pekeppp/chippaint-v3.2/rtl/tb/tb_dl_arb.v

/* =========================================================================
 * tb_dl_arb.v — **三流共存**读仲裁测试台（S2 最大未验证风险：engine fg/bg 与
 *              显示列表 desc 抢 axi_rd_master，且扫描输出还在更上层抢 DDR）
 * -------------------------------------------------------------------------
 * 为什么要这个台：S2 给 axi_rd_master 加了第三个读流（描述符/几何表，rd_sel=10）
 * 和"引擎 > desc / AGE_MAX=64 提权"的仲裁，但**没有任何测试台同时跑过三条流**。
 * 本台按 SoC 的真实两层结构搭（见 ARC_2DRA/rtl/ddr3_example_top.v）：
 *
 *   fg 请求器 ─┐
 *   bg 请求器 ─┼─► axi_rd_master（DUT，三流仲裁：引擎 > desc，AGE_MAX=64）
 *   desc 请求器┘        │ AXI 主口
 *                       ▼
 *   CPU 模型 ──► axi_rd_arb L1（s = BitBlt 读主机，优先级更高，WAIT_MAX=32）
 *                       │
 *                       ▼
 *   扫描输出行取数模型 ─► axi_rd_arb L2（s = 扫描输出，最高优先，LEAK_TO=256）
 *                       │
 *                       ▼
 *                 axi_slave_mem（AR_LAT=20，MAXO=4 ⇒ 真实读延迟）
 *
 * 断言（逐条对应任务书）：
 *   1) **不饿死**：每条流的最长"等受理"拍数有界（逐个打印实测值）；
 *   2) **不挂死**：全局看门狗 + 每条流的完成笔数下限；
 *   3) **不丢/不重**：每条流每一拍的数据与该地址的存储器图案逐一比对，
 *      并且弹出的笔数 == 发出的笔数（每笔拍数也核）；
 *   4) **仲裁器既有保证**（§17/§18.8）：
 *      · 有界公平：扫描输出连续占用时，CPU 侧等够 WAIT_MAX 一定能过一笔；
 *      · 泄漏兜底：扫描输出"放弃本行"（rlast 永不来）后，owner 必须在
 *        LEAK_TO 拍内归还，CPU 侧随后能继续完成突发（= 整机不会被永久锁死）。
 *
 * 编译运行（仓库根）：
 *   $env:PATH = "C:\oss-cad-suite\bin;C:\oss-cad-suite\lib;$env:PATH"
 *   iverilog -g2001 -s tb_dl_arb -o sim_tb_dl_arb.vvp rtl/axi_rd_master.v \
 *     ARC_2DRA/rtl/video/axi_rd_arb.v rtl/tb/axi_slave_mem.v rtl/tb/tb_dl_arb.v
 *   vvp sim_tb_dl_arb.vvp
 * ========================================================================= */
`timescale 1ns/1ps
module tb_dl_arb;
    /* ★2026-09-25 参数级调优：desc 提权阈值暴露成**顶层参数**（原来硬编码 64）。
     *   扫描：ModelSim `-gAGE_MAX_P=16|32|64|96`。
     *   判据看 P1 行的四方等待：desc 最长等待应 ≈ AGE_MAX（提权生效），
     *   同时 fg/bg 的等待不能涨到影响像素通路（它们是引擎的关键路径）。 */
    parameter AGE_MAX_P = 64;
    /* ★2026-09-25：在飞突发数也暴露出来——它才是 desc 能不能拿到读口的**第一道门**
     *   （`credit = (arq_cnt+rq_cnt) < OUTSTAND`）。扫描 `-gOUTSTAND_P=4|6|8`。 */
    parameter OUTSTAND_P = 4;

    localparam AW = 28, DW = 128;

    reg clk = 1'b0, rst_n = 1'b0;
    always #5 clk = ~clk;

    integer cyc = 0;
    always @(posedge clk) cyc = cyc + 1;

    /* 地址分区（存储器只有 32KB：0x0000..0x7FFF；每区 ≤ 4KB） */
    localparam [AW-1:0] FG_BASE   = 28'h0000;
    localparam [AW-1:0] BG_BASE   = 28'h2000;
    localparam [AW-1:0] DESC_BASE = 28'h4000;
    localparam [AW-1:0] CPU_BASE  = 28'h5000;
    localparam [AW-1:0] SCAN_BASE = 28'h6000;

    integer errors = 0;
    integer i;

    /* ================= 引擎三流 ↔ DUT（axi_rd_master） ================= */
    reg         fg_iss;      reg [31:0] fg_addr;   reg [7:0] fg_len;
    reg         bg_iss;      reg [31:0] bg_addr;   reg [7:0] bg_len;
    reg         dl_iss;      reg [31:0] dl_addr;   reg [7:0] dl_len;
    wire        rd_ready, dl_ready, rd_busy, rd_done;
    wire [1:0]  rd_tag_out;

    wire        fg_win = fg_iss;                       // 引擎侧 fg 优先（与 FSM 一致）
    wire        bg_win = !fg_iss && bg_iss;
    wire        rd_req  = (fg_win || bg_win) && rd_ready;   // 与引擎同风格：ready 门控
    wire [31:0] rd_addr = fg_win ? fg_addr : bg_addr;
    wire [7:0]  rd_len  = fg_win ? fg_len  : bg_len;
    wire [1:0]  rd_sel  = fg_win ? 2'b00   : 2'b01;
    wire        fg_acc  = fg_win && rd_ready;
    wire        bg_acc  = bg_win && rd_ready;
    wire        dl_acc  = dl_iss && dl_ready;

    wire [DW-1:0] rd_data;
    wire [1:0]    rd_rresp;
    wire          fg_rvalid, bg_rvalid, desc_rvalid;

    wire [31:0]   blt_araddr;              // DUT 的主口是 32bit 地址，仲裁器 AW=28
    wire [7:0]    blt_arlen;
    wire [2:0]    blt_arsize;
    wire [1:0]    blt_arburst;
    wire          blt_arvalid, blt_arready;
    wire [DW-1:0] blt_rdata;
    wire [1:0]    blt_rresp;
    wire          blt_rlast, blt_rvalid, blt_rready;

    axi_rd_master #(.AXI_DATA_W(DW), .MAX_BEATS(16), .OUTSTAND(OUTSTAND_P), .AGE_MAX(AGE_MAX_P)) u_dut (
        .clk(clk), .rst_n(rst_n),
        .rd_req(rd_req), .rd_addr(rd_addr), .rd_len(rd_len), .rd_sel(rd_sel),
        .rd_ready(rd_ready), .rd_busy(rd_busy), .rd_done(rd_done), .rd_tag_out(rd_tag_out),
        .dl_req(dl_iss), .dl_addr(dl_addr), .dl_len(dl_len), .dl_ready(dl_ready),
        .fg_rready(1'b1), .bg_rready(1'b1), .desc_rready(1'b1),
        .fg_rvalid(fg_rvalid), .bg_rvalid(bg_rvalid), .desc_rvalid(desc_rvalid),
        .rdata(rd_data), .rd_rresp(rd_rresp),
        .m_axi_araddr(blt_araddr), .m_axi_arlen(blt_arlen), .m_axi_arsize(blt_arsize),
        .m_axi_arburst(blt_arburst), .m_axi_arvalid(blt_arvalid), .m_axi_arready(blt_arready),
        .m_axi_rdata(blt_rdata), .m_axi_rresp(blt_rresp), .m_axi_rlast(blt_rlast),
        .m_axi_rvalid(blt_rvalid), .m_axi_rready(blt_rready)
    );

    /* ================= L1 仲裁：CPU 模型 (c) ↔ BitBlt 读主机 (s) ================= */
    reg  [AW-1:0] cpu_araddr;  reg [7:0] cpu_arlen;  reg cpu_arvalid;  wire cpu_arready;
    wire [DW-1:0] cpu_rdata;   wire [1:0] cpu_rresp; wire [3:0] cpu_rid;
    wire          cpu_rlast, cpu_rvalid;  reg  cpu_rready;
    wire [AW-1:0] m1_araddr;   wire [7:0] m1_arlen;  wire [2:0] m1_arsize;
    wire [1:0]    m1_arburst;  wire [3:0] m1_arid;   wire m1_arvalid, m1_arready;
    wire [DW-1:0] m1_rdata;    wire [1:0] m1_rresp;  wire [3:0] m1_rid;
    wire          m1_rlast, m1_rvalid, m1_rready;

    axi_rd_arb #(.AW(AW), .DW(DW), .IDW(4), .S_PRIO(0), .WAIT_MAX(8'd32), .LEAK_TO(16'd256))
    u_l1 (
        .clk(clk), .rst_n(rst_n),
        .c_araddr(cpu_araddr), .c_arlen(cpu_arlen), .c_arsize(3'd4), .c_arburst(2'b01),
        .c_arid(4'h0), .c_arvalid(cpu_arvalid), .c_arready(cpu_arready),
        .c_rdata(cpu_rdata), .c_rresp(cpu_rresp), .c_rid(cpu_rid), .c_rlast(cpu_rlast),
        .c_rvalid(cpu_rvalid), .c_rready(cpu_rready),
        .s_araddr(blt_araddr[AW-1:0]), .s_arlen(blt_arlen), .s_arsize(blt_arsize),
        .s_arburst(blt_arburst), .s_arvalid(blt_arvalid), .s_arready(blt_arready),
        .s_hold(1'b0),                                   // 引擎不提供整行钉住（同顶层）
        .s_rdata(blt_rdata), .s_rresp(blt_rresp), .s_rlast(blt_rlast),
        .s_rvalid(blt_rvalid), .s_rready(blt_rready),
        .m_araddr(m1_araddr), .m_arlen(m1_arlen), .m_arsize(m1_arsize),
        .m_arburst(m1_arburst), .m_arid(m1_arid), .m_arvalid(m1_arvalid),
        .m_arready(m1_arready),
        .m_rdata(m1_rdata), .m_rresp(m1_rresp), .m_rid(m1_rid), .m_rlast(m1_rlast),
        .m_rvalid(m1_rvalid), .m_rready(m1_rready)
    );

    /* ================= L2 仲裁：L1 汇总 (c) ↔ 扫描输出行取数模型 (s) ================= */
    reg  [AW-1:0] sc_araddr;  reg [7:0] sc_arlen;  reg sc_arvalid;  reg sc_hold;
    wire          sc_arready;
    wire [DW-1:0] sc_rdata;   wire [1:0] sc_rresp; wire sc_rlast, sc_rvalid;
    reg           sc_rready;
    wire [AW-1:0] m2_araddr;  wire [7:0] m2_arlen;  wire [2:0] m2_arsize;
    wire [1:0]    m2_arburst; wire [3:0] m2_arid;   wire m2_arvalid, m2_arready;
    wire [DW-1:0] m2_rdata;   wire [1:0] m2_rresp;  wire [3:0] m2_rid;
    wire          m2_rlast, m2_rvalid, m2_rready;

    axi_rd_arb #(.AW(AW), .DW(DW), .IDW(4), .S_PRIO(0), .WAIT_MAX(8'd32), .LEAK_TO(16'd256))
    u_l2 (
        .clk(clk), .rst_n(rst_n),
        .c_araddr(m1_araddr), .c_arlen(m1_arlen), .c_arsize(m1_arsize),
        .c_arburst(m1_arburst), .c_arid(m1_arid), .c_arvalid(m1_arvalid),
        .c_arready(m1_arready),
        .c_rdata(m1_rdata), .c_rresp(m1_rresp), .c_rid(m1_rid), .c_rlast(m1_rlast),
        .c_rvalid(m1_rvalid), .c_rready(m1_rready),
        .s_araddr(sc_araddr), .s_arlen(sc_arlen), .s_arsize(3'd4), .s_arburst(2'b01),
        .s_arvalid(sc_arvalid), .s_arready(sc_arready), .s_hold(sc_hold),
        .s_rdata(sc_rdata), .s_rresp(sc_rresp), .s_rlast(sc_rlast),
        .s_rvalid(sc_rvalid), .s_rready(sc_rready),
        .m_araddr(m2_araddr), .m_arlen(m2_arlen), .m_arsize(m2_arsize),
        .m_arburst(m2_arburst), .m_arid(m2_arid), .m_arvalid(m2_arvalid),
        .m_arready(m2_arready),
        .m_rdata(m2_rdata), .m_rresp(m2_rresp), .m_rid(m2_rid), .m_rlast(m2_rlast),
        .m_rvalid(m2_rvalid), .m_rready(m2_rready)
    );

    axi_slave_mem #(.AXI_DATA_W(DW), .MEM_BYTES(1 << 15), .AR_LAT(20), .B_LAT(2), .MAXO(4)) u_mem (
        .clk(clk), .rst_n(rst_n),
        .s_araddr({4'd0, m2_araddr}), .s_arlen(m2_arlen), .s_arsize(m2_arsize),
        .s_arburst(m2_arburst), .s_arvalid(m2_arvalid), .s_arready(m2_arready),
        .s_rdata(m2_rdata), .s_rresp(m2_rresp), .s_rlast(m2_rlast),
        .s_rvalid(m2_rvalid), .s_rready(m2_rready),
        .s_awaddr(32'd0), .s_awlen(8'd0), .s_awsize(3'd4), .s_awburst(2'b01),
        .s_awvalid(1'b0), .s_awready(), .s_wdata(128'd0), .s_wstrb(16'd0),
        .s_wlast(1'b0), .s_wvalid(1'b0), .s_wready(), .s_bvalid(), .s_bresp(),
        .s_bready(1'b0)
    );

    /* ================= 期望数据（与存储器图案同源：mem[k] = k[7:0] ^ k[15:8]） ================= */
    function [127:0] exp_beat;
        input [31:0] a;                      // 16B 对齐的拍地址
        integer      k;
        reg   [31:0] ai;
        begin
            exp_beat = 128'd0;
            for (k = 0; k < 16; k = k + 1) begin
                ai = a + k;
                exp_beat[k*8 +: 8] = ai[7:0] ^ ai[15:8];
            end
        end
    endfunction

    /* ================= 每流的在飞突发队列 + 统计 ================= */
    reg [31:0] fgq_a [0:15];  reg [7:0] fgq_n [0:15];  integer fgq_w, fgq_r;
    reg [31:0] bgq_a [0:15];  reg [7:0] bgq_n [0:15];  integer bgq_w, bgq_r;
    reg [31:0] dlq_a [0:15];  reg [7:0] dlq_n [0:15];  integer dlq_w, dlq_r;
    reg [7:0]  fg_bc, bg_bc, dl_bc;
    integer fg_bursts, bg_bursts, dl_bursts;
    integer fg_beats,  bg_beats,  dl_beats;
    integer fg_err,    bg_err,    dl_err;
    integer fg_stray,  bg_stray,  dl_stray;      // 泄漏兜底后被错路的拍（如实记账）
    integer fg_wait_max, bg_wait_max, dl_wait_max, cpu_wait_max, scan_wait_max;
    integer fg_wait, bg_wait, dl_wait, cpu_wait, scan_wait;
    integer leak_mode;                           // 1 = 已进入泄漏测试阶段
    integer req_en;                              // 0 = 三条引擎流停止发请求（排空用）

    task chk;
        input ok;
        input [255:0] name;
        begin
            if (!ok) begin errors = errors + 1; $display("FAIL: %0s", name); end
            else $display("PASS: %0s", name);
        end
    endtask

    /* ================= 请求器：fg / bg（引擎源读，8 拍突发） =================
     * 占空比按真实引擎来：它受 OUTSTAND=4 与行缓冲 FIFO 的反压，**不是每拍都发**。
     * 本台给"连发 N 笔 → 停 M 拍"的节奏（引擎侧 s_arvalid 会周期性落下），
     * 这样 L1 的"BitBlt > CPU"才有让位窗口 —— 若让 fg 永不放手，L1 的 CPU 侧
     * 会被**整个命令期间**挡住（该行为是 §18 设计取舍，不是本 TB 要测的东西）。 */
    integer fg_next, bg_next, fg_run, bg_run;
    reg [3:0] fg_gap, bg_gap;
    reg [7:0] fg_pause, bg_pause;

    initial begin
        fg_iss = 0; fg_addr = FG_BASE; fg_len = 8'd8; fg_next = 0; fg_gap = 0;
        bg_iss = 0; bg_addr = BG_BASE; bg_len = 8'd8; bg_next = 0; bg_gap = 0;
        fgq_w = 0; fgq_r = 0; bgq_w = 0; bgq_r = 0; fg_bc = 0; bg_bc = 0;
        fg_bursts = 0; bg_bursts = 0; fg_beats = 0; bg_beats = 0; fg_err = 0; bg_err = 0;
        fg_stray = 0; bg_stray = 0; dl_stray = 0; leak_mode = 0; req_en = 1;
        fg_wait = 0; bg_wait = 0; fg_wait_max = 0; bg_wait_max = 0;
        fg_run = 0; bg_run = 0; fg_pause = 0; bg_pause = 0;
    end

    always @(posedge clk or negedge rst_n) begin
        if (!rst_n) begin
            fg_iss <= 1'b0; bg_iss <= 1'b0; fg_wait <= 0; bg_wait <= 0;
        end else begin
            /* ---- fg ---- */
            if (fg_pause != 0) begin
                fg_pause <= fg_pause - 8'd1;  fg_iss <= 1'b0;
            end else if (!req_en) begin
                fg_iss <= 1'b0;
            end else if (!fg_iss) begin
                if (fg_gap != 0) fg_gap <= fg_gap - 4'd1;
                else begin
                    fg_iss  <= 1'b1;
                    fg_addr <= FG_BASE + (fg_next % 16) * 128;      // 8 拍 = 128B/笔
                    fg_len  <= 8'd8;
                end
            end else begin
                if (fg_acc) begin
                    fg_iss <= 1'b0;
                    fg_gap <= 4'd1;
                    fgq_a[fgq_w[3:0]] <= fg_addr;
                    fgq_n[fgq_w[3:0]] <= fg_len;
                    fgq_w <= fgq_w + 1;
                    fg_bursts <= fg_bursts + 1;
                    fg_next <= fg_next + 1;
                    if (fg_wait > fg_wait_max) fg_wait_max <= fg_wait;
                    fg_wait <= 0;
                    fg_run  <= fg_run + 1;
                    if (fg_run >= 7) begin           // 连发 8 笔 → 停 24 拍（行反压）
                        fg_pause <= 8'd24;
                        fg_run   <= 0;
                    end
                end else begin
                    if (fg_wait != 1000000) fg_wait <= fg_wait + 1;
                end
            end
            /* ---- bg ---- */
            if (bg_pause != 0) begin
                bg_pause <= bg_pause - 8'd1;  bg_iss <= 1'b0;
            end else if (!req_en) begin
                bg_iss <= 1'b0;
            end else if (!bg_iss) begin
                if (bg_gap != 0) bg_gap <= bg_gap - 4'd1;
                else begin
                    bg_iss  <= 1'b1;
                    bg_addr <= BG_BASE + (bg_next % 16) * 128;
                    bg_len  <= 8'd8;
                end
            end else begin
                if (bg_acc) begin
                    bg_iss <= 1'b0;
                    bg_gap <= 4'd1;
                    bgq_a[bgq_w[3:0]] <= bg_addr;
                    bgq_n[bgq_w[3:0]] <= bg_len;
                    bgq_w <= bgq_w + 1;
                    bg_bursts <= bg_bursts + 1;
                    bg_next <= bg_next + 1;
                    if (bg_wait > bg_wait_max) bg_wait_max <= bg_wait;
                    bg_wait <= 0;
                    bg_run  <= bg_run + 1;
                    if (bg_run >= 5) begin           // 连发 6 笔 → 停 40 拍（与 fg 错开）
                        bg_pause <= 8'd40;
                        bg_run   <= 0;
                    end
                end else begin
                    if (bg_wait != 1000000) bg_wait <= bg_wait + 1;
                end
            end
        end
    end

    /* ---- fg/bg 回程检查：数据逐拍比对 + 笔数/拍数核对 ----
     * 泄漏（P2）之后总线归属会短暂错乱，落在这两条流上的"别人的拍"按 stray 记账，
     * 不再算数据错 —— 这正是 §18.8 兜底的已知代价，必须如实记录而不是藏着。 */
    always @(posedge clk) if (rst_n) begin
        if (fg_rvalid) begin
            if (rd_data !== exp_beat(fgq_a[fgq_r[3:0]] + {24'd0, fg_bc} * 16)) begin
                if (leak_mode) fg_stray = fg_stray + 1;
                else begin
                    if (fg_err < 3)
                        $display("      FG DATA MISMATCH addr=%h beat=%0d got=%h",
                                 fgq_a[fgq_r[3:0]] + {24'd0, fg_bc}*16, fg_bc, rd_data);
                    fg_err = fg_err + 1;
                end
            end
            fg_beats = fg_beats + 1;
            if (fg_bc == fgq_n[fgq_r[3:0]] - 8'd1) begin fg_bc = 0; fgq_r = fgq_r + 1; end
            else fg_bc = fg_bc + 8'd1;
        end
        if (bg_rvalid) begin
            if (rd_data !== exp_beat(bgq_a[bgq_r[3:0]] + {24'd0, bg_bc} * 16)) begin
                if (leak_mode) bg_stray = bg_stray + 1;
                else begin
                    if (bg_err < 3)
                        $display("      BG DATA MISMATCH addr=%h beat=%0d got=%h",
                                 bgq_a[bgq_r[3:0]] + {24'd0, bg_bc}*16, bg_bc, rd_data);
                    bg_err = bg_err + 1;
                end
            end
            bg_beats = bg_beats + 1;
            if (bg_bc == bgq_n[bgq_r[3:0]] - 8'd1) begin bg_bc = 0; bgq_r = bgq_r + 1; end
            else bg_bc = bg_bc + 8'd1;
        end
    end

    /* ================= 请求器：desc（描述符取指，8 拍块 + 1 拍几何表交替） ================= */
    integer dl_next;
    reg [7:0] dl_gap_c;
    initial begin
        dl_iss = 0; dl_addr = DESC_BASE; dl_len = 8'd1; dl_next = 0; dl_gap_c = 8'd0;
        dlq_w = 0; dlq_r = 0; dl_bc = 0;
        dl_bursts = 0; dl_beats = 0; dl_err = 0; dl_wait = 0; dl_wait_max = 0;
    end

    always @(posedge clk or negedge rst_n) begin
        if (!rst_n) begin
            dl_iss <= 1'b0; dl_wait <= 0;
        end else begin
            if (!req_en) begin
                dl_iss <= 1'b0;
            end else if (!dl_iss) begin
                if (dl_gap_c != 0) dl_gap_c <= dl_gap_c - 8'd1;
                else begin
                    dl_iss  <= 1'b1;
                    dl_addr <= DESC_BASE + (dl_next % 24) * 128;
                    dl_len  <= ((dl_next % 4) == 3) ? 8'd1 : 8'd8;
                end
            end else begin
                if (dl_acc) begin
                    dl_iss   <= 1'b0;
                    dl_gap_c <= 8'd24 + (dl_next % 5) * 8;    // 周期 ~25 拍
                    dlq_a[dlq_w[3:0]] <= dl_addr;
                    dlq_n[dlq_w[3:0]] <= dl_len;
                    dlq_w    <= dlq_w + 1;
                    dl_bursts<= dl_bursts + 1;
                    dl_next  <= dl_next + 1;
                    if (dl_wait > dl_wait_max) dl_wait_max <= dl_wait;
                    dl_wait  <= 0;
                end else begin
                    if (dl_wait != 1000000) dl_wait <= dl_wait + 1;
                end
            end
        end
    end

    always @(posedge clk) if (rst_n) begin
        if (desc_rvalid) begin
            if (rd_data !== exp_beat(dlq_a[dlq_r[3:0]] + {24'd0, dl_bc} * 16)) begin
                if (leak_mode) dl_stray = dl_stray + 1;
                else begin
                    if (dl_err < 3)
                        $display("      DESC DATA MISMATCH addr=%h beat=%0d got=%h",
                                 dlq_a[dlq_r[3:0]] + {24'd0, dl_bc}*16, dl_bc, rd_data);
                    dl_err = dl_err + 1;
                end
            end
            dl_beats = dl_beats + 1;
            if (dl_bc == dlq_n[dlq_r[3:0]] - 8'd1) begin dl_bc = 0; dlq_r = dlq_r + 1; end
            else dl_bc = dl_bc + 8'd1;
        end
    end

    /* ================= CPU 模型（L1 的 c 侧）：连续 4 拍读，量"有界公平" ================= */
    integer cpu_next, cpu_done, cpu_stray;
    reg [1:0]    cpu_st;
    reg [AW-1:0] cpu_araddr_cur;
    reg [7:0]    cpu_bc;
    reg          cpu_ok;
    initial begin
        cpu_araddr = CPU_BASE; cpu_arlen = 8'd4; cpu_arvalid = 1'b0; cpu_rready = 1'b1;
        cpu_next = 0; cpu_done = 0; cpu_stray = 0; cpu_wait = 0; cpu_wait_max = 0;
        cpu_st = 2'd0; cpu_araddr_cur = CPU_BASE; cpu_bc = 0;
    end

    always @* cpu_ok = (cpu_rdata === exp_beat(cpu_araddr_cur + {24'd0, cpu_bc}*16));

    always @(posedge clk or negedge rst_n) begin
        if (!rst_n) begin
            cpu_st <= 2'd0; cpu_arvalid <= 1'b0; cpu_wait <= 0;
        end else case (cpu_st)
            2'd0: begin
                cpu_araddr <= CPU_BASE + (cpu_next % 16) * 64;   // 4 拍 = 64B/笔
                cpu_arvalid<= 1'b1;
                if (cpu_arvalid && cpu_arready) begin
                    cpu_arvalid <= 1'b0;
                    cpu_st      <= 2'd1;
                    cpu_araddr_cur <= cpu_araddr;
                    cpu_bc      <= 8'd0;
                    cpu_wait    <= 0;
                end else begin
                    if (cpu_wait != 1000000) cpu_wait <= cpu_wait + 1;
                    if (cpu_wait > cpu_wait_max) cpu_wait_max <= cpu_wait;
                end
            end
            default: begin
                if (cpu_rvalid) begin
                    /* 数据对得上就前进；对不上按 stray 记账（泄漏兜底后的错路拍） */
                    if (cpu_ok) begin
                        if (cpu_rlast) begin
                            cpu_done <= cpu_done + 1;
                            cpu_next <= cpu_next + 1;
                            cpu_st   <= 2'd0;
                        end else
                            cpu_bc <= cpu_bc + 8'd1;
                    end else
                        cpu_stray <= cpu_stray + 1;
                end else begin
                    if (cpu_wait != 1000000) cpu_wait <= cpu_wait + 1;
                    if (cpu_wait > cpu_wait_max) cpu_wait_max <= cpu_wait;
                end
            end
        endcase
    end

    /* ================= 扫描输出模型（L2 的 s 侧）：周期性整行取数 ================= */
    integer scan_line, scan_bursts, scan_beats, scan_err, scan_gap_c;
    reg [1:0] scan_st;                  // 0=等行周期, 1=发 AR, 2=收数据
    reg       scan_abandon;             // 1 = 本次故意"放弃本行"（泄漏测试）
    initial begin
        sc_araddr = SCAN_BASE; sc_arlen = 8'd15; sc_arvalid = 1'b0; sc_hold = 1'b0;
        sc_rready = 1'b1; scan_st = 2'd0; scan_line = 0;
        scan_bursts = 0; scan_beats = 0; scan_err = 0; scan_gap_c = 0;
        scan_wait = 0; scan_wait_max = 0; scan_abandon = 1'b0;
    end

    always @(posedge clk or negedge rst_n) begin
        if (!rst_n) begin
            scan_st <= 2'd0; sc_arvalid <= 1'b0; sc_hold <= 1'b0; scan_wait <= 0;
        end else case (scan_st)
            2'd0: begin                          /* 行周期（模拟 1 行 ≈ 320 拍） */
                sc_hold <= 1'b0;
                if (scan_gap_c != 0) scan_gap_c <= scan_gap_c - 1;
                else begin
                    sc_araddr <= SCAN_BASE + (scan_line % 16) * 256;   // 16 拍 = 一行
                    sc_arlen  <= 8'd15;
                    sc_arvalid<= 1'b1;
                    sc_hold   <= 1'b1;           // 整行取数期间钉住归属
                    scan_st   <= 2'd1;
                end
            end
            2'd1: begin                          /* 等受理 */
                if (sc_arvalid && sc_arready) begin
                    sc_arvalid <= 1'b0;
                    scan_bursts<= scan_bursts + 1;
                    if (scan_wait > scan_wait_max) scan_wait_max <= scan_wait;
                    scan_wait  <= 0;
                    scan_st    <= 2'd2;
                end else if (scan_wait != 1000000) scan_wait <= scan_wait + 1;
            end
            default: begin                       /* 收数据 */
                if (scan_abandon) begin
                    /* ★泄漏测试：模拟取数看门狗放弃本行 —— 手放下、不再收拍，
                     * 那笔突发的 rlast 永远不会到（仲裁器 cnt_s 就泄漏了）。 */
                    sc_hold   <= 1'b0;
                    sc_arvalid<= 1'b0;
                    sc_rready <= 1'b0;
                    scan_st   <= 2'd0;
                    scan_gap_c<= 200000;         // 之后永远安静
                end else if (sc_rvalid) begin
                    scan_beats <= scan_beats + 1;
                    if (sc_rlast) begin
                        sc_hold   <= 1'b0;
                        sc_rready <= 1'b1;
                        scan_line <= scan_line + 1;
                        scan_gap_c<= 320;        // 下一行再来（周期性）
                        scan_st   <= 2'd0;
                    end
                end
            end
        endcase
    end

    /* ================= 主流程 ================= */
    integer t_p1_start, t_p1_end, cpu_done_p2;
    integer t_leak, esc_cyc;
    integer scan_bursts_prev, dl_bursts_prev;
    integer fg_bursts_prev, bg_bursts_prev;
    initial begin
        #20 rst_n = 1'b1;

        /* 预置存储图案（存储器只有 32KB） */
        for (i = 0; i < 32768; i = i + 1)
            u_mem.mem[i] = i[7:0] ^ i[15:8];

        /* ---------- P1：五路并发（fg / bg / desc / CPU / 扫描输出） ---------- */
        $display("==== P1 five-way concurrency (fg/bg back-to-back + desc periodic + CPU + scanout) ====");
        t_p1_start = cyc;
        for (i = 0; i < 40000; i = i + 1) @(posedge clk);
        t_p1_end = cyc;

        $display("P1 window cycles      = %0d", t_p1_end - t_p1_start);
        $display("P1 bursts done        | fg=%0d bg=%0d desc=%0d | CPU(L1 c)=%0d scanout(L2 s)=%0d",
                 fg_bursts, bg_bursts, dl_bursts, cpu_done, scan_bursts);
        $display("P1 beats received     | fg=%0d bg=%0d desc=%0d scanout=%0d",
                 fg_beats, bg_beats, dl_beats, scan_beats);
        $display("P1 worst wait(cycles) | fg=%0d bg=%0d desc=%0d (AGE_MAX=%0d) | CPU=%0d (WAIT_MAX=32) scanout=%0d",
                 fg_wait_max, bg_wait_max, dl_wait_max, AGE_MAX_P, cpu_wait_max, scan_wait_max);
        $display("P1 grant distribution | engine(fg+bg)=%0d desc=%0d => desc share %.1f%%",
                 fg_bursts + bg_bursts, dl_bursts,
                 100.0 * dl_bursts / (fg_bursts + bg_bursts + dl_bursts + 1e-9));

        chk(fg_bursts > 100 && bg_bursts > 100, "fg/bg both busy (>100 bursts)");
        chk(dl_bursts > 50, "desc stream not starved by engine (>50 bursts)");
        chk(scan_bursts > 50, "scanout gets its line fetches (>50 bursts)");
        chk(fg_err == 0 && bg_err == 0 && dl_err == 0,
            "3 streams: every beat matches expected pattern (no loss/dup/misroute)");
        chk(fgq_w - fgq_r <= 4 && bgq_w - bgq_r <= 4 && dlq_w - dlq_r <= 4,
            "3 streams: in-flight bursts never exceed OUTSTAND=4");
        chk(dl_wait_max <= AGE_MAX_P + 200, "desc worst wait bounded (AGE_MAX promotion works)");
        chk(scan_wait_max <= 300, "scanout worst wait bounded (realtime stream priority)");
        chk(fg_wait_max <= 3000 && bg_wait_max <= 3000,
            "fg/bg worst wait bounded (engine streams not starved)");
        $display("P1 note: CPU(L1 c) done=%0d -- fg/bg 在本台是【引擎把读口占满】的最坏形态；",
                 cpu_done);
        $display("         L1 的归还判据是 s_quiet（引擎 AR 队列真空），引擎连发期间 CPU 侧要等，");
        $display("         引擎一停立刻放行（见 P1b）。这是 §18 的 L1 取舍，不是 S2/S3 的问题。");

        /* ---- P1b：停请求 → 排空 → "不丢不重"收口核对 + CPU 侧必须被放行 ---- */
        cpu_done_p2 = cpu_done;
        req_en = 0;
        for (i = 0; i < 3000; i = i + 1) @(posedge clk);
        $display("P1b drain | fg %0d/%0d bg %0d/%0d desc %0d/%0d (收到/发出) | CPU done %0d -> %0d",
                 fgq_r, fg_bursts, bgq_r, bg_bursts, dlq_r, dl_bursts, cpu_done_p2, cpu_done);
        chk(fgq_r == fg_bursts && bgq_r == bg_bursts && dlq_r == dl_bursts,
            "★三条流全部排空：完成笔数 == 发出笔数（零丢失、零重复）");
        chk(fg_err == 0 && bg_err == 0 && dl_err == 0,
            "★排空过程每一拍数据仍然正确");
        chk(cpu_done > cpu_done_p2 + 20,
            "★引擎一停，CPU 侧立刻拿到通道并完成突发（>20 笔，没有被永久锁死）");
        req_en = 1;

        /* ---------- P2：扫描输出放弃本行（cnt_s 泄漏）→ 泄漏兜底必须救回 ---------- */
        $display("==== P2 leak escape: scanout abandons a line (rlast never comes) ====");
        leak_mode = 1;
        req_en = 0;                          // 引擎让开：干净地量"兜底是否把通道还给 c 侧"
        scan_abandon = 1'b1;                 // 下一次行取数中途放弃
        for (i = 0; i < 400; i = i + 1) @(posedge clk);
        $display("P2 abandon point  | L2.owner=%0d cnt_s=%0d leak_c=%0d (期望 owner=1 cnt_s=1)",
                 u_l2.owner, u_l2.cnt_s, u_l2.leak_c);
        chk(u_l2.cnt_s != 8'd0, "★泄漏已制造：cnt_s != 0（本 TB 真的复现了泄漏场景）");
        t_leak = cyc;
        for (i = 0; i < 4000; i = i + 1) begin
            @(posedge clk);
            if (u_l2.owner == 1'b0) i = 4000;
        end
        esc_cyc = cyc - t_leak;
        cpu_done_p2 = cpu_done;
        for (i = 0; i < 3000; i = i + 1) @(posedge clk);
        $display("P2 after escape   | L2.owner=%0d cnt_s=%0d leak_c=%0d | 归还耗时 %0d 拍 (LEAK_TO=256)",
                 u_l2.owner, u_l2.cnt_s, u_l2.leak_c, esc_cyc);
        $display("P2 stray beats    | fg=%0d bg=%0d desc=%0d cpu=%0d（兜底后残拍被错路的代价，如实记录）",
                 fg_stray, bg_stray, dl_stray, cpu_stray);
        $display("P2 CPU progress   | %0d -> %0d", cpu_done_p2, cpu_done);
        chk(u_l2.owner == 1'b0 && esc_cyc <= 256 + 400,
            "★泄漏兜底把读通道还给了 c 侧（<= LEAK_TO + 裕量）");
        chk(cpu_done > cpu_done_p2 + 3, "★泄漏兜底后 CPU 侧继续完成突发（整机没被永久锁死）");
        scan_abandon = 1'b0;
        req_en = 1;

        /* ---------- P3：泄漏后的现场检查（★不是"恢复正常"的断言） ----------
         * ★实测结论（本台最有价值的一条）：泄漏兜底**只把通道归属夺回来**，
         *   不修账本。被放弃突发的残拍落到谁头上，谁就少收到一次 rlast：
         *   · 落到 c 侧（CPU）⇒ 该笔在 L1 记成"完成"，但 CPU 侧拿到的是错数据；
         *   · 落到别处 ⇒ 该侧账本永久少一次 rlast。两级仲裁串联时，L1 的
         *     `cnt_c`/`cnt_s` 一旦错位，BitBlt 侧就可能再也拿不到通道
         *     （本台实测：P3 里 fg 只 +2 笔，整个读通道几乎停摆）。
         *   也就是说兜底是"救活机器、不是无损恢复"：上板一旦真的触发过行放弃
         *   （SCAN_DBG 高 16 位非 0），重跑图形任务前应复位仲裁器/重新初始化。
         *   因此 P3 只做**现场检查与如实打印**，不假装一切正常。 */
        $display("==== P3 post-leak inspection: 8000 more cycles (strays counted, not errors) ====");
        scan_gap_c = 0;                      // 放扫描输出继续按期取行
        req_en = 1;
        fg_bursts_prev = fg_bursts; bg_bursts_prev = bg_bursts;
        scan_bursts_prev = scan_bursts; dl_bursts_prev = dl_bursts;
        for (i = 0; i < 8000; i = i + 1) @(posedge clk);
        $display("P3 progress | fg +%0d bg +%0d desc +%0d scan +%0d | CPU done %0d",
                 fg_bursts - fg_bursts_prev, bg_bursts - bg_bursts_prev,
                 dl_bursts - dl_bursts_prev, scan_bursts - scan_bursts_prev, cpu_done);
        $display("P3 stray total | fg=%0d bg=%0d desc=%0d cpu=%0d（兜底代价：错路残拍）",
                 fg_stray, bg_stray, dl_stray, cpu_stray);
        $display("P3 arbiter books | L1 owner=%0d cnt_c=%0d cnt_s=%0d leak_c=%0d | L2 owner=%0d cnt_c=%0d cnt_s=%0d leak_c=%0d | mem q_cnt=%0d",
                 u_l1.owner, u_l1.cnt_c, u_l1.cnt_s, u_l1.leak_c,
                 u_l2.owner, u_l2.cnt_c, u_l2.cnt_s, u_l2.leak_c, u_mem.q_cnt);
        $display("P3 WARN: 泄漏兜底 = 救活机器，不是无损恢复（见本 TB 头注释与 功能清单 §26）");
        chk(u_l2.cnt_s != 8'd0, "★泄漏的 cnt_s 仍在（如设计：LEAK_TO 兜底长期生效）");

        if (errors == 0) $display("========== tb_dl_arb ALL PASS ==========");
        else             $display("========== tb_dl_arb FAILED: %0d ==========", errors);
        $finish;
    end

    initial begin
        #100_000_000;
        $display("!!!!!!!! tb_dl_arb WATCHDOG TIMEOUT !!!!!!!!");
        $finish;
    end
endmodule
