pekeppp/chippaint-v3.2/(commit log)

2026-10-28 ARC_2DRA: SoC top, DDR3 controller, Efinity project, BSP
    [external.cfg, flash.cfg, flash_softTap.cfg, flash_ti.cfg, flash_tz.cfg, ftdi.cfg, ftdi_ti.cfg, ftdi_tz.cfg]
2026-10-28 outflow: fit/route artifacts + bitstream (7/14, 59 MB)
    [ddr_demo_ti60.interface.csv, ddr_demo_ti60.pinout.csv, ddr_demo_ti60.res.csv]
2026-10-28 outflow: fit/route artifacts + bitstream (8/14, 57.8 MB)
    [ddr3_example_top.res.csv, edb_top.res.csv]
